UVicFH/PowerDistElectrical/Bill of Materials-RPD_top.xlsx

Please order green highlighted rows. Use number wanted if we can afford
Supplier Part Number 1 | Part Description | # Board Uses | # Have | Min Number Needed | Number Wanted | Note
A98338-ND | 8 pin screw terminal | 2 | 1 | 3 | 3
RG32P1.0MBCT-ND | 1M resistor .1% | 7 | 16 | 0 | 0
SSM3K329RLFCT-ND | N-channel FET 30V 3.5A | 9 | 17 | 0 | 0
RHM1.0MPCT-ND | 1M resistor 5% | 12 | 12 | 12 | 20
587-5425-1-ND | 47uF Capacitor 16V | 4 | 0 | 8 | 10
S1B-FDICT-ND | Flyback diode (1n4001 equivalent) | 3 | 0 | 6 | 10
RNCF1206BKE453RCT-ND | Resistor 453 ohm | 2 | 8 | 0 | 0
CKN9865-ND | Switch | 1 | 0 | 1 | 2
PB768-ND | Relay | 1 | 0 | 2 | 2
1516-1172-1-ND | Red LED | 9 | 6 | 12 | 12
NDP6020P-ND | P-channel FET T0-220 | 3 | 0 | 6 | 10 | Expensive but blow often!! More is better. Must be T0220
RNCP1206FTD511RCT-ND | 511 ohm resistors 1% | 4 | 26 | 0 | 0
RG32P510BCT-ND | 510 ohm resistors 0.1% | 5 | 14 | 0 | 0
BAT42W-FDICT-ND | Diode Shottky 30V 200mA | 5 | 0 | 10 | 10
S10D-TPMSCT-ND | Diode 200V 10A | 3 | 0 | 6 | 10
S7006-ND | 8 pin header | 1 | 0 | 2 | 2
S7008-ND | 10 pin header | 1 | 0 | 2 | 2
S9404-ND | 8 pin male header | 2 | 0 | 4 | 4
S9407-ND | 2 pin male header | 1 | 0 | 2 | 2
LM2940CT-5.0/NOPB-ND | linear reg | 1 | 0 | 2 | 2
732-1242-1-ND | inductor | 1 | 0 | 2 | 2
478-8496-1-ND | 10 uF cap | 2 | 9 | -5 | 0
478-8468-1-ND | 22uF cap | 2 | 6 | 0 | 0
ATMEGA328P-AU-ND | arduino chip | 1 | 0 | 2 | 4
ATTINY2313-20SURCT-ND | bootloader | 1 | 0 | 2 | 4
609-4700-1-ND | usb header | 1 | 0 | 2 | 2
MC74ACT125DR2GOSDKR-ND | buffer | 1 | 0 | 2 | 2
MCP2515-I/SO-ND | can chip | 1 | 0 | 2 | 2
MCP2551-E/SN-ND | can chip | 1 | 0 | 2 | 2
490-1198-1-ND | resonator 16Mhz | 2 | 0 | 4 | 6
535-10007-6-ND | resonator 12Mhz | 1 | 0 | 2 | 4
160-1456-1-ND | green LED | 1 | 0 | 2 | 5 | *burn out easily
296-12290-6-ND | 5v regulator | 1 | 1 | 1 | 2
311-27ERCT-ND | 27 ohm resistor | 2 | 8 | 0 | 0
399-1285-1-ND | 0.33uF cap | 1 | 4 | 0 | 0
RNCS1206BKE10K0CT-ND | 10K resistor | 2 | 0 | 4 | 10
P16.9KBCCT-ND | 16.9k resistor | 1 | 0 | 2 | 10
