UVicFH/PowerDistElectrical/gerberanddrillLower/BOM/RPD_Lower.xlsx

Comment | Description | Designator | Footprint | LibRef | Quantity | Supplier 1 | Supplier Part Number 1
0.1uF | 0603, 0.1uF | C1, C3, C4 | C1206 | Capacitor | 3 | Digi-Key, [NoParam] | 399-5615-1-ND
 | Capacitor (Semiconductor SIM Model) | C2 | C1206 | Cap Semi | 1 | Digi-Key | 399-1285-1-ND
PWR | Typical RED, GREEN, YELLOW, AMBER GaAs LED | D1 | 3.2X1.6X1.1 | LED2 | 1 | Digi-Key | 160-1456-1-ND (https://octopart-clicks.com/click/altium?sku=160-1456-1-ND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)
LED0 | Typical INFRARED GaAs LED | D3, D5, D7, D9, D11, D12, D14, D19 | C1206 | LED0 | 8 | Digi-Key | 1516-1172-1-ND (https://octopart-clicks.com/click/altium?sku=1516-1172-1-ND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)
Diode | Default Diode | D4, D6, D8 | S10D-TP | Diode | 3 | Digi-Key | BAT42W-FDICT-ND (https://octopart-clicks.com/click/altium?sku=BAT42W-FDICT-ND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)
Diode | Default Diode | D10, D13, D16, D20 | sod-123 | Diode | 4 | Digi-Key | BAT42W-FDICT-ND (https://octopart-clicks.com/click/altium?sku=BAT42W-FDICT-ND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)
Diode | Default Diode | D15 | SOD-323 | Diode | 1 | Digi-Key | BAT42W-FDICT-ND (https://octopart-clicks.com/click/altium?sku=BAT42W-FDICT-ND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)
ICSP |  | J1 | ICSP Connector | ICSP Connector | 1 | Digi-Key | 952-2121-ND (https://octopart-clicks.com/click/altium?sku=952-2121-ND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)
Header 8 | Header, 8-Pin | P3 | HDR1X8 | Header 8 | 1 | Digi-Key | S7006-ND
Header 10 | Header, 10-Pin | P4 | HDR1X10 | Header 10 | 1 | Digi-Key | S7008-ND
MOSFET-P | P-Channel MOSFET | Q1, Q2, Q4 | TO-220 | MOSFET-P | 3 | Digi-Key | SSM3J334RLFCT-ND (https://octopart-clicks.com/click/altium?sku=SSM3J334RLFCT-ND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)
MOSFET-N | N-Channel MOSFET | Q3, Q5, Q7, Q9, Q12, Q13, Q18, Q31 | SOT23f | MOSFET-N | 8 | Digi-Key | SSM3K329RLFCT-ND (https://octopart-clicks.com/click/altium?sku=SSM3K329RLFCT-ND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)
MOSFET-P | P-Channel MOSFET | Q8, Q10, Q11, Q14, Q17 | SOT23f | MOSFET-P | 5 | Digi-Key | SSM3J334RLFCT-ND (https://octopart-clicks.com/click/altium?sku=SSM3J334RLFCT-ND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)
16.9K | 0603 | R2 | C1206 | Resistor | 1 | Digi-Key | P16.9KBCCT-ND (https://octopart-clicks.com/click/altium?sku=P16.9KBCCT-ND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)
1k | 0603 | R3, R6, R9 | C1206 | Resistor | 3 | Digi-Key | P1.0KBCCT-ND (https://octopart-clicks.com/click/altium?sku=P1.0KBCCT-ND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)
10K0 | 0603 | R4, R5 | C1206 | Resistor | 2 | Digi-Key | RNCS1206BKE10K0CT-ND (https://octopart-clicks.com/click/altium?manufacturer=Stackpole%20Electronics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)
27 | 0603 | R7, R8 | C1206 | Resistor | 2 | Digi-Key | P1.0KBCCT-ND (https://octopart-clicks.com/click/altium?sku=P1.0KBCCT-ND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)
100 | 0603 | R10, R11 | C1206 | Resistor | 2 | Digi-Key | P1.0KBCCT-ND (https://octopart-clicks.com/click/altium?sku=P1.0KBCCT-ND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)
22k | 0603 | R12 | C1206 | Resistor | 1 | Digi-Key | P1.0KBCCT-ND (https://octopart-clicks.com/click/altium?sku=P1.0KBCCT-ND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)
1206 | Resistor | R13, R16, R20, R21, R22, R23, R26, R27, R28, R29, R30, R31, R35, R36, R37, R53 | C1206 | Res1 | 16 | Digi-Key | RNCP1206FTD511RCT-ND, RG32P510BCT-ND, RG32P1.0MBCT-ND (https://octopart-clicks.com/click/altium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)
1206 | Resistor, 1M Resistor | R14, R15, R17, R18, R52, R54 | 1206 (High Density) | Res1 | 6 | Digi-Key | RG32P1.0MBCT-ND (https://octopart-clicks.com/click/altium?sku=RG32P1.0MBCT-ND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)
Res1 | Resistor | R24, R25 | C1206 | Res1 | 2 | Digi-Key | RHM1.0MPCT-ND (https://octopart-clicks.com/click/altium?sku=RHM1.0MPCT-ND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)
PTS525SM15SMTR2 |  | SW1 | PTS525SM15SMTR2 | PTS525SM15SMTR2 | 1 | Digi-Key | CKN9104CT-ND (https://octopart-clicks.com/click/altium?sku=CKN9104CT-ND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)
UA7805CKTTR | 12V to 5V LDO 296-12290-1-ND | U1 | SOT223 | UA7805CKTTR | 1 | Digi-Key | 296-12290-6-ND (https://octopart-clicks.com/click/altium?sku=296-12290-6-ND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)
MCP2551-E/SN | SOIC | U2 | SOIC127P600X175-8M | MCP2551-E/SN | 1 | Digi-Key | MCP2551-E/SN-ND (https://octopart-clicks.com/click/altium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)
MCP2515-E/ST | SOIC | U3 | SOIC127P1030X265-18M | MCP2515-E/ST | 1 | Digi-Key | MCP2515-I/SO-ND (https://octopart-clicks.com/click/altium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)
ATMEGA328P | TQFN | U4 | ATMEGA328P-15AZ - 2 | ATMEGA328P | 1 | Digi-Key | ATMEGA328P-AU-ND (https://octopart-clicks.com/click/altium?manufacturer=Microchip%20%2F%20Atmel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)
74ACT125D | Buffer MC74ACT125DTR2GOSCT-ND | U5 | 14 pin buffer | 74ACT125D | 1 | Digi-Key | MC74ACT125DTR2GOSDKR-ND (https://octopart-clicks.com/click/altium?manufacturer=ON%20Semiconductor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)
ATTINY2313-20S | ATTINY | U6 | ATTINY | ATTINY2313-20S | 1 | Digi-Key | ATTINY2313-20SURCT-ND
USB Header | USB mini B 609-4700-1-ND | USB1 | USBminiB | USB Header | 1 | Digi-Key | 609-4700-1-ND (https://octopart-clicks.com/click/altium?sku=609-4700-1-ND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)
MX150-20 | Header, 10-Pin, Dual row | X2 | 20 Pin MX150 | Header 10X2A | 1 | Mouser
CSTCE16M0V53-R0 | 16MHz 15pf resonator 490-1198-1-ND, [NoValue] | Y1, Y2 | CSTCE16M0V53-R0 | CSTCE16M0V53-R0 | 2 | Digi-Key | 535-10007-6-ND (https://octopart-clicks.com/click/altium?sku=535-10007-6-ND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)
CSTCE16M0V53-R0 | 16MHz 15pf resonator 490-1198-1-ND | Y3 | 12MHzCRES | CSTCE16M0V53-R0 | 1 | Digi-Key | 535-10007-6-ND (https://octopart-clicks.com/click/altium?sku=535-10007-6-ND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)
