UVicFH/PowerDistElectrical/(list of files, drawings)

Other design files:
Controller.SchDoc
FuelPump.SchDoc
Fusing_Connectors.SchDoc
HighCurrentSwitch.SchDoc
IMDAMSLatching.SchDoc
LowCurrentSwitch.SchDoc
Rear Power Dist.SchDoc
Rear_Power_Distribution.PrjPcb
Rear_Power_Lower.PrjPcb
RearPowerLower.SchDoc
ResetCircuit.SchDoc
RPD_lower.PcbDoc
RPD_top.PcbDoc
Shut_Down_Circuit.PrjPcb
Shutdown_Circuit.SchDoc
SpareSwitch.SchDoc
