UVicFH/PowerDistElectrical/(threads)

Thread 1 (2017-10-25):

Front Power Distribution

thaddow, 2017-10-25:
A few outputs from last year were the incorrect voltages. We need more 12V outputs than 5V outputs. The dash needs to be 12V.

We need LEDs for when a signal is high from any button/ power source. This will help debugging since anything that is not working, the light will be off when GLV is on.

thaddow, 2017-10-25:
We need LEDs for when a signal is high from any button/ power source. This will help debugging since anything that is not working, the light will be off when GLV is on.

smithbeuvic, 2017-10-28:
First task: (1) Look up power outputs and verify that their power source is the correct voltage. Switch the components that require 12v to appropriate location. ( Spare must be 12v)
(2) Look up the max appropriate current draw for each components (output to the components ) and verify that the fuses are appropriate and will meet rules. Consult the formula hybrid rules EV6.1 pg 102. Or use the following links http://www.formula-hybrid.org/pdf/fusing-tutorial-rev1.pdf. The rules can be found here BTW http://www.formula-hybrid.org/wp-content/uploads/2018-Formula-Hybrid-Rules-Rev-0.pdf

tmurias, 2017-10-28:
I think someone should also take a look at the 5V regulators being used. We're using 2 different ones and I'm not sure why. I think some chips might need more stable power than others, but maybe there's a limit on how many things can draw current?

Thread 2 (2017-10-25):

Rear Power Distribution

thaddow, 2017-10-25:
Need to learn about the arduino/ CANduino interface and ensure that the rear power distribution PCB is correct.

Need to add more debugging LEDs or just a better layout with labels on the PCB (i.e engine fan, wheel sensors, etc.).

Need to correct the PCB footprints for a few components

thaddow, 2017-10-25:
Need to add more debugging LEDs or just a better layout with labels on the PCB (i.e engine fan, wheel sensors, etc.).

thaddow, 2017-10-25:
Need to correct the PCB footprints for a few components

smithbeuvic, 2017-10-28:
(1) Correct the footprint on the Transistors q-16 and q-29.
 (2) Look up the d2 diode to find an appropriate replacement that has a larger footprint.
 (3) Verify that all outputs are giving the correct voltage to components and that fuses are correctly rated. ( same task as Front power distribution )

thaddow, 2018-04-27:
For 2018/2019 board:
- Replace LEDs with more robust option, also maybe look into how to ensure that if they fail that they fail the way we want them to (probably depends on the circuit whether we want them to fail short or open)
- fix the fuel pump flyback diode to a larger diode (1206 packaging)
- directional capacitors need directional footprints (on 12-5 DC to DC circuit)
- check the packaging for the ceramic resonators, it wasn't quite the right size
- maintain a similar layout with the circuits divided into labelled boxes
- the spare circuit needs its own box
- capacitors need to be closer to their respective parts, some of them were too far away (i.e from the 5V linear regulator on the controller)
- one of the fuses wasn't connected to an output pin
- The AMS status and IMD status LEDs didn't have output pins
- Increase the size of all power trace widths
- move signal traces further away from all power traces
- Add a header for Rx / Tx
- Remove all outputs from Rx/ Tx and move them to different IO pins

thaddow, 2018-04-27:
lets make into 1 board because I think cost is less important than reliability and easy test accessibility. Unless you can think of a better way of running down to the bottom board that can handle more current than the headers we have (maybe a larger pitch?) but that still doesn't really solve the issue of possible board fracture if we are pulling them apart frequently

thaddow, 2018-04-27:
oh! Also, ground plane needs to connect in more spots so that we don't have any possible islands or ground loops

thaddow, 2018-04-27:
make sure the switch in the reset circuit is connected and that the series resistances were removed, not sure how up to date the files here are

TannerOleksiuk, 2018-07-16:
high noise input output protection
