UVicFH/PowerDistElectrical/(commit log)

2017-12-16 Added 2017-2018 files via upload
    Completed and in progress schematics for the rear power and shutdown/ reset circuits. PCBs are not completed.
    [Controller.SchDoc, Fusing_Connectors.SchDoc, HighCurrentSwitch.SchDoc, LowCurrentSwitch.SchDoc, Rear Power Dist.SchDoc, Rear_Power_Distribution.PrjPcb, ResetCircuit.SchDoc, Shut_Down_Circuit.PrjPcb]
2017-12-22 3PDT Relays
    Added 3PDT latching relays for the AMS and IMD statuses.
    The push button is now double pole.
    Removed the MOSFET switching.
    Added headers to the fusing connector board.
    [ResetCircuit.SchDoc]
2018-01-06 Changed all caps to 1206 package and 2x required V rating Added supplier part number to all caps
    [Controller.SchDoc, Fusing_Connectors.SchDoc, Rear_Power_Distribution.PrjPcb, ResetCircuit.SchDoc]
2018-01-09 Removed shut down circuit project Made lower pcb project with low current switching and controller Moved Reset circuit to top power distribution pcb Added headers from top to lower rear power pcb
    [Controller.SchDoc, Fusing_Connectors.SchDoc, Rear_Power_Distribution.PrjPcb]
2018-01-09 added headers
    [HighCurrentSwitch.SchDoc]
2018-01-09 Removed headers that weren't needed
    [ResetCircuit.SchDoc]
2018-01-10 includes top board projects
    [Rear Power Dist.SchDoc]
2018-01-10 Changed header to a 10 and 6 screw terminal, changed arrangement of schematic. I have the old one for reference when assembling
    [ResetCircuit.SchDoc]
2018-01-10 changes to top board
    [Rear_Power_Distribution.PrjPcb]
2018-01-10 Added lower rear power distribution board project
    [Rear_Power_Lower.PrjPcb]
2018-01-10 lower schematic
    [RearPowerLower.SchDoc]
2018-01-11 Switched all resistors to 1206 package Switched low current switch resistors to 510 ohm to save ~ $20
    [Controller.SchDoc, LowCurrentSwitch.SchDoc, ResetCircuit.SchDoc]
2018-01-12 Added components
    [ResetCircuit.SchDoc]
2018-01-15 Added pushbutton footprint and changed pinout of schematic symbol
    [ResetCircuit.SchDoc]
2018-01-15 updated LEDs
    [LowCurrentSwitch.SchDoc]
2018-01-16 Changed diodes to 14N001 equivalent (over 50V, 1A) to meet rules for flyback on relays, and updated packaging accordingly
    [ResetCircuit.SchDoc]
2018-01-22 Created PCB
    [RPD_lower.PcbDoc]
2018-01-22 updated differential pairs
    [Controller.SchDoc]
2018-01-22 changed headers
    [Fusing_Connectors.SchDoc]
2018-01-22 updated for pcb
    [HighCurrentSwitch.SchDoc]
2018-01-22 added missing footprints
    [LowCurrentSwitch.SchDoc]
2018-01-22 updated headers
    [RearPowerLower.SchDoc]
2018-01-22 added libraries, changed project documents and re-compiled
    [Rear_Power_Lower.PrjPcb]
2018-01-22 re-compiled changes from schematics
    [Rear_Power_Distribution.PrjPcb]
2018-01-22 added pcb for rpdu top
    [RPD_top.PcbDoc]
2018-01-22 changed designators
    [Fusing_Connectors.SchDoc]
2018-02-11 Added net labels, supplier links, fixed indexing for resistors
    [Controller.SchDoc]
2018-02-11 finished indexing
    [Controller.SchDoc]
2018-02-11 connected buffer to bootloader
    [Controller.SchDoc]
2018-02-12 Fixed usb part
    [Controller.SchDoc]
2018-02-12 Fixed all errors for net labels; still dealing with Designator and file missing error
    [Controller.SchDoc]
2018-02-12 Fixed all errors
    [Controller.SchDoc]
2018-02-12 Re-indexed resistors
    [HighCurrentSwitch.SchDoc]
2018-02-12 fixed grid errors
    [RearPowerLower.SchDoc]
2018-02-12 Added spare switch
    [SpareSwitch.SchDoc]
2018-02-12 re-compiled and fixed errors
    [Rear_Power_Lower.PrjPcb]
2018-02-12 Most traces finished!!
    [RPD_top.PcbDoc]
2018-02-15 board completed
    [Rear_Power_Distribution.PrjPcb]
2018-02-15 completed top board
    [RPD_top.PcbDoc]
2018-02-15 generated output files for fabrication
    [RPD_top.DRL, RPD_top.GBL, RPD_top.GBO, RPD_top.GBP, RPD_top.GBS, RPD_top.GKO, RPD_top.GM1, RPD_top.GTL]
2018-02-17 generated drill and gerber files for lower board
    [RPD_Lower.DRL, RPD_Lower.GBL, RPD_Lower.GBO, RPD_Lower.GBP, RPD_Lower.GBS, RPD_Lower.GKO, RPD_Lower.GM1, RPD_Lower.GTL]
2018-02-17 generated updated gerber and drill files for top board
    [Copy of Bill of Materials-RPD_top.xlsx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]
2018-02-20 finalized board, checked all errors
    [RPD_Lower.DRL, RPD_Lower.GBL, RPD_Lower.GBS, RPD_Lower.GKO, RPD_Lower.GTL, RPD_Lower.GTO, RPD_Lower.GTP, RPD_Lower.GTS]
2018-02-20 finalized board checked all errors
    [Copy of Bill of Materials-RPD_top.xlsx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]
2018-02-20 fixed ports for spare and brakesol
    [Controller.SchDoc]
2018-02-20 finalized and fixed spares
    [Fusing_Connectors.SchDoc]
2018-02-20 finalized project
    [Rear_Power_Distribution.PrjPcb]
2018-02-20 fixed spares and brakesol and finalized
    [RearPowerLower.SchDoc]
2018-02-20 finalized, switched to spare1
    [SpareSwitch.SchDoc]
2018-02-21 added ams status and imd status, re-routed and re-generated
    [Copy of Bill of Materials-RPD_top.xlsx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]
2018-02-21 added ams status and imd status to go to reset circuit
    [Fusing_Connectors.SchDoc]
2018-02-21 finalized top board
    [Rear_Power_Distribution.PrjPcb]
2018-02-21 added traces for ams status and imd status and removed cpbrb to bottom board (unnecessary)
    [RPD_top.PcbDoc]
2018-02-21 added ams and imd status to connectors
    [RearPowerLower.SchDoc]
2018-02-21 added ams and imd traces and removed unnecessary cpbrb connections; still NEED to flip P4 on pcb and re-route
    [Rear_Power_Lower.PrjPcb]
2018-02-21 added imd and ams straces removed cpbrb connection to P3, need to flip and re-route P4
    [RPD_lower.PcbDoc]
2018-02-21 added ams status and imd status and regenerated
    [RPD_Lower.xlsx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]
2018-02-24 updated out job and did design review of pin in out and connector locations
    [FuelPump.SchDoc, SpareSwitch.SchDoc]
2018-02-27 Fixed hole clearance issue
    [RPD_lower.PcbDoc]
2018-03-01 updated BOM
    [Copy of Bill of Materials-RPD_top.xlsx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]
2018-03-13 edited pins of controller
    [Controller.SchDoc]
2018-03-25 ben told me to - CM
    [Controller.SchDoc, Fusing_Connectors.SchDoc, RPD_lower.PcbDoc, Rear_Power_Lower.PrjPcb]
2018-03-28 deleted r4 and r2 from reset circuit
    [ResetCircuit.SchDoc]
2018-04-01 Add files via upload
    BOM
    [Bill of Materials-RPD_top.xlsx]
2018-04-17 most up to date changes
    [Bill of Materials-RPD_top.xlsx, Controller.SchDoc, Fusing_Connectors.SchDoc, IMDAMSLatching.SchDoc, RPD_lower.PcbDoc, RearPowerLower.SchDoc, Rear_Power_Lower.PrjPcb, Shut_Down_Circuit.PrjPcb]
